MikeTrainor/RoboCupSoccerPlatformDesign/README.md

# RoboCupSoccerPlatformDesign

This repository will contain all software developed as a part of the 2018/2019 ENGG 4000 course project, "RoboCup Soccer Platform Design."
