MikeTrainor/RoboCupSoccerPlatformDesign/(list of files, cad)

Other CAD files:
End of Project Final Documents/3D Models/PCB_mountv2.f3d
End of Project Final Documents/3D Models/robotTopv6.f3d
