MikeTrainor/RoboCupSoccerPlatformDesign/(commit log)

2018-11-24 Added current iteration of CV system
2019-01-12 Method of calculating angle that does not work
    Doesn't work because of the assumption that a fixed angle will be found irregardless of orientation between the centre dot and the ID dot
    [AngleCalculations.py]
2019-02-13 Cleaned up cv without particle filter
2019-02-14 Fixed up, partially optimized, fully commented
    [AngleCalculations.py]
2019-03-07 Add files via upload
    This code works to some degree. In the Getdata() function, the if statement that checks the positions does not work
    [InnerLoopMbed+RecieverCode2.h]
2019-04-11 PCB Mount and Robot Top
    [PCB_mount v2.f3d, top_redesign_valueadded v6.f3d]
